B45i/Talking-Smart-Glass-For-Blind/images/IMG_20180605_092308.jpg

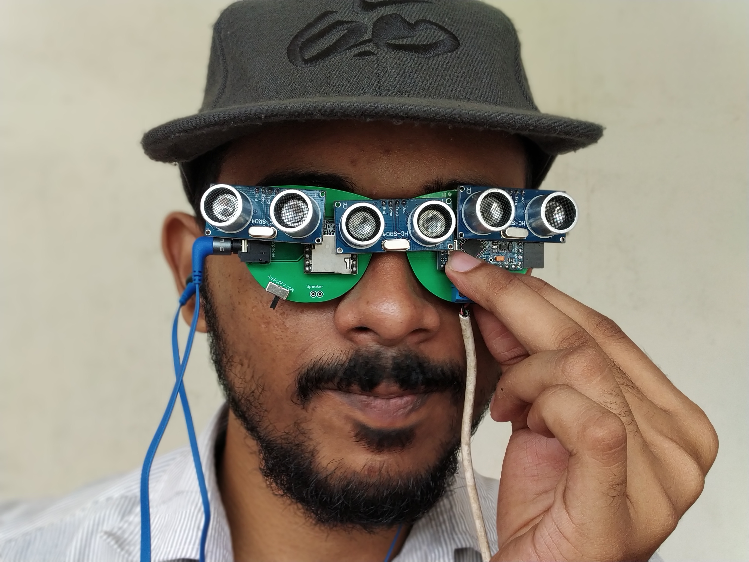
images/IMG_20180605_092308.jpg
